JeremyLesauvage/LUT-Lixie-Universal-Tuner/ICT Showroom Winner Certificate.jpg

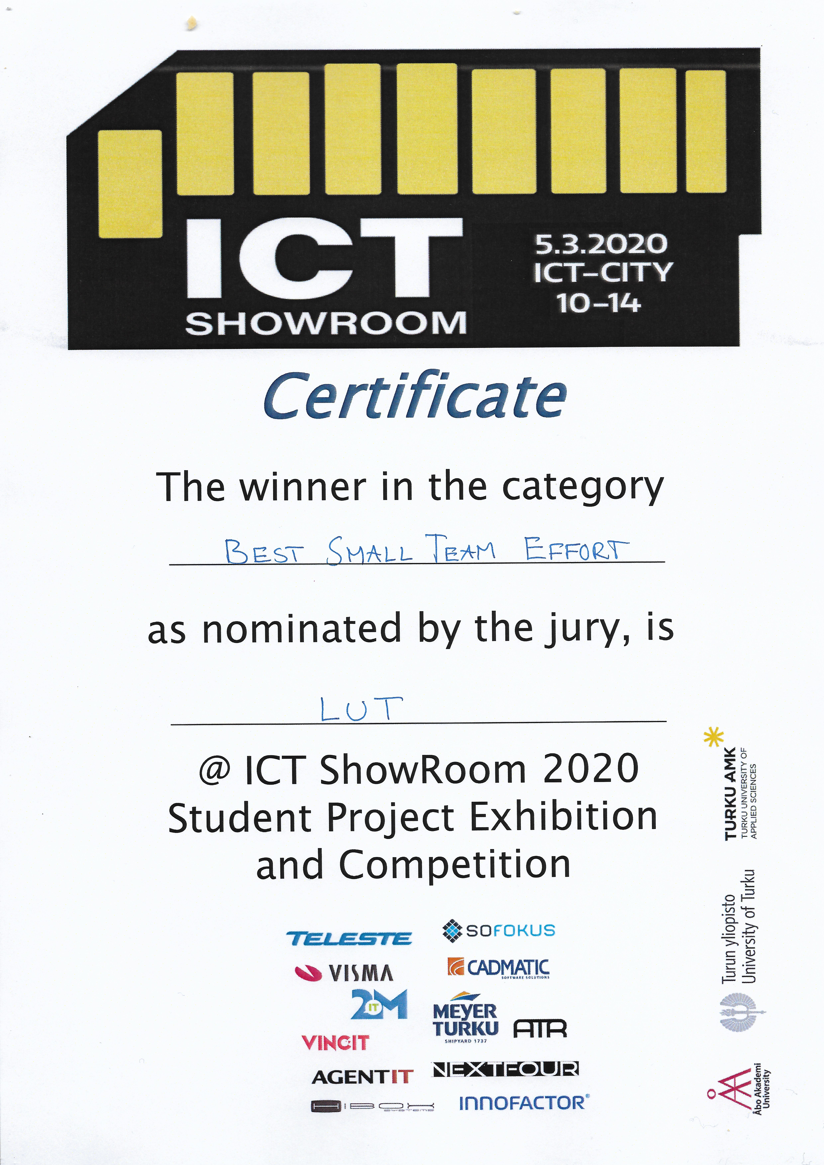
ICT Showroom Winner Certificate.jpg
