JeremyLesauvage/LUT-Lixie-Universal-Tuner/Mic calibration.xlsx

 | Generated freq | Tuner result before calibration | Ratio gene/result | Factor to calibrate
1 | 155.56 | 168 | 0.925952381
2 | 164.81 | 175 | 0.9417718798
3 | 174.61 | 184 | 0.9489684578 | 0.9388975728
4 | 184.99 | 192 | 0.9635055146
5 | 195.99 | 200 | 0.9799665926
6 | 207.65 | 213 | 0.9748717733 | 0.9727812935
7 | 220.00 | 233 | 0.9441848144
8 | 233.08 | 246 | 0.9474660524 | 0.9458254334
9 | 246.94 | 256 | 0.9645941705 | 0.9645941705
10 | 261.62 | 268 | 0.9761928833 | 0.9761928833
11 | 277.18 | 292 | 0.949234278
12 | 293.66 | 309 | 0.9503500847 | 0.9497921814
13 | 311.12 | 322 | 0.9662111801
14 | 329.62 | 340 | 0.9694710527 | 0.9678411164
15 | 349.22 | 368 | 0.9489684578 | 0.9489684578
16 | 369.99 | 384 | 0.9635055146 | 0.9635055146
17 | 392.00 | 406 | 0.9655172414 | 0.9655172414
18 | 415.30 | 436.5 | 0.9514318442 | 0.9514318442
19 | 440.00 | 455 | 0.967032967 | 0.967032967
20 | 466.1637615 | 490 | 0.9513546153 | 0.9513546153
21 | 493.88 | 512 | 0.9646158228
22 | 523.25 | 549 | 0.9530985985 | 0.9588572107
23 | 554.37 | 576 | 0.9624396909
24 | 587.33 | 616 | 0.9534570387 | 0.9579483648
25 | 622.25 | 645 | 0.9647348332
26 | 659.26 | 690 | 0.955442194 | 0.9600885136
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
