JeremyLesauvage/LUT-Lixie-Universal-Tuner/(commit log)

2020-03-10 Add files via upload
    Information on how the microphone was calibrated
    [Mic calibration.xlsx]
2020-03-10 Add files via upload
    Wiring of the Arduino board to the sensor and other electronics.
